jijiaceness/custom-keyboard/photos/info.json_in_progress.png

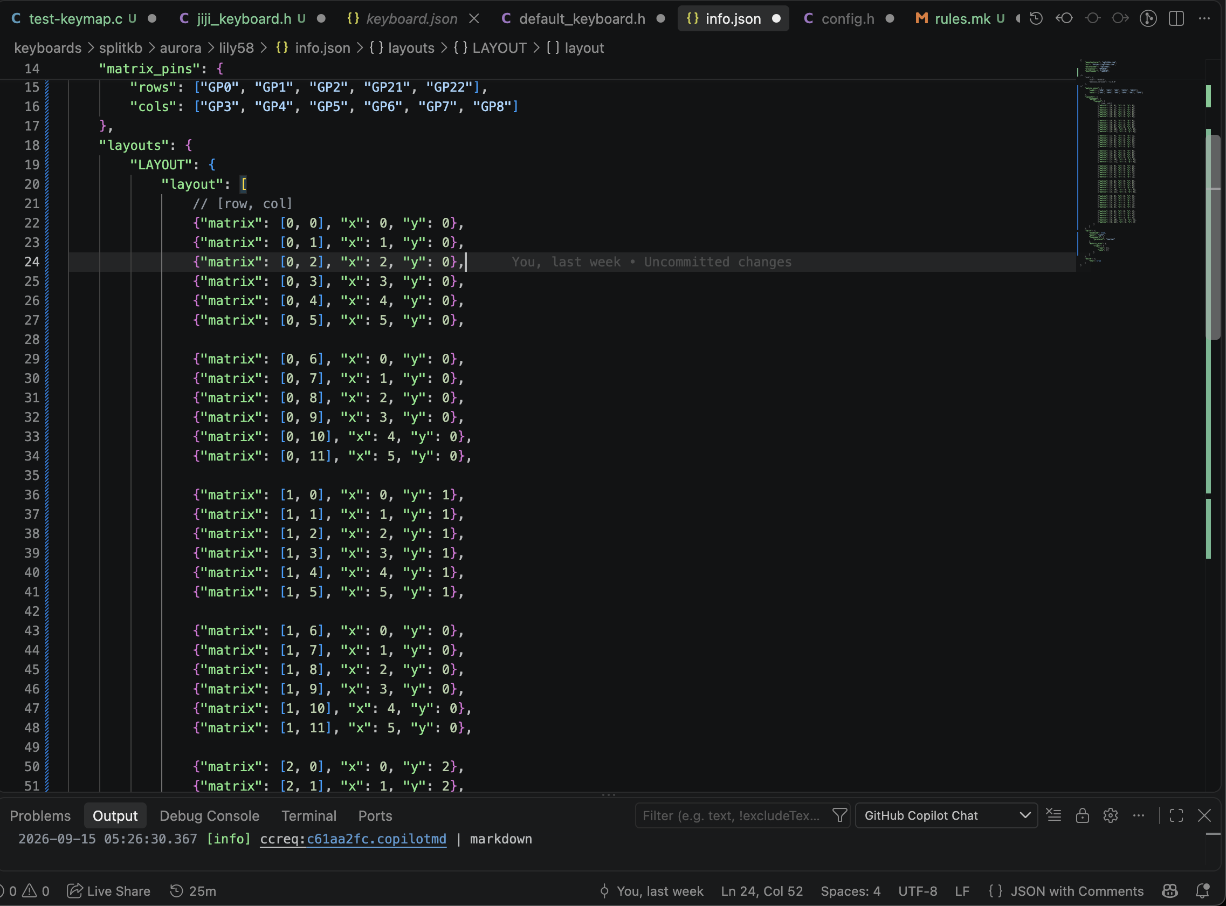
photos/info.json_in_progress.png
