jijiaceness/custom-keyboard/photos/JLCPCB left keeb quote.png

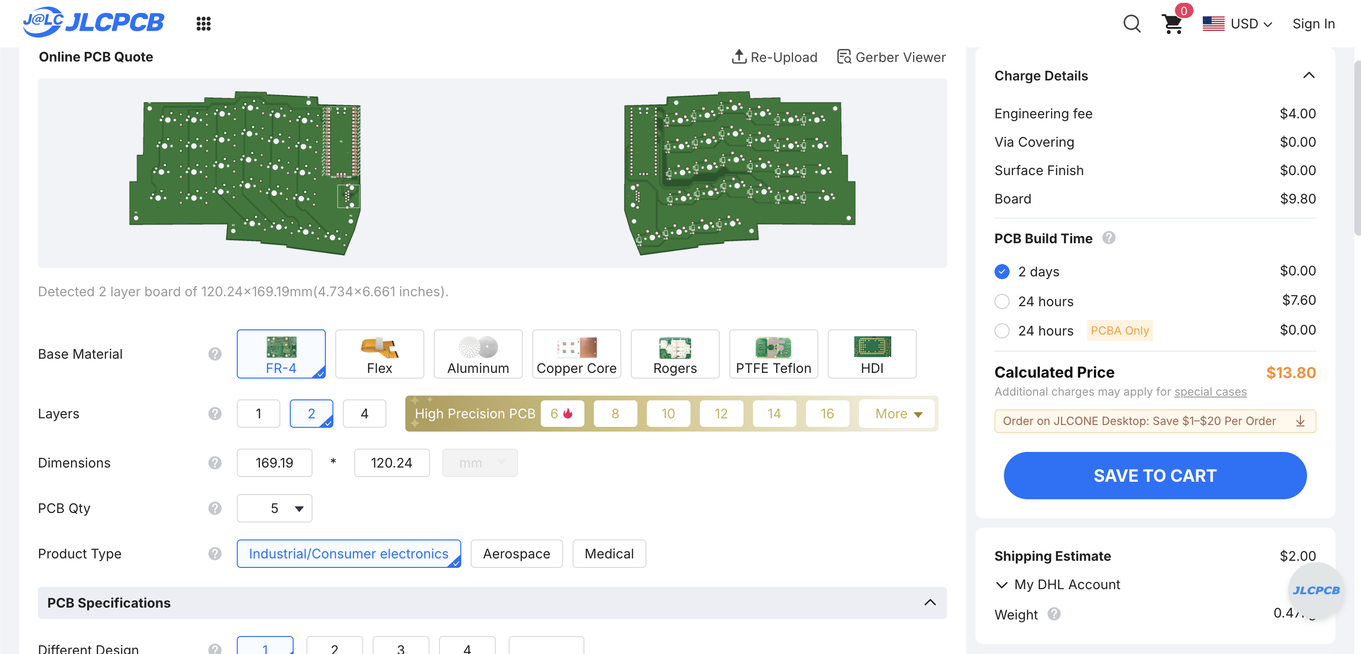
photos/JLCPCB left keeb quote.png
