jijiaceness/custom-keyboard/photos/keeb - model of pcb back.png

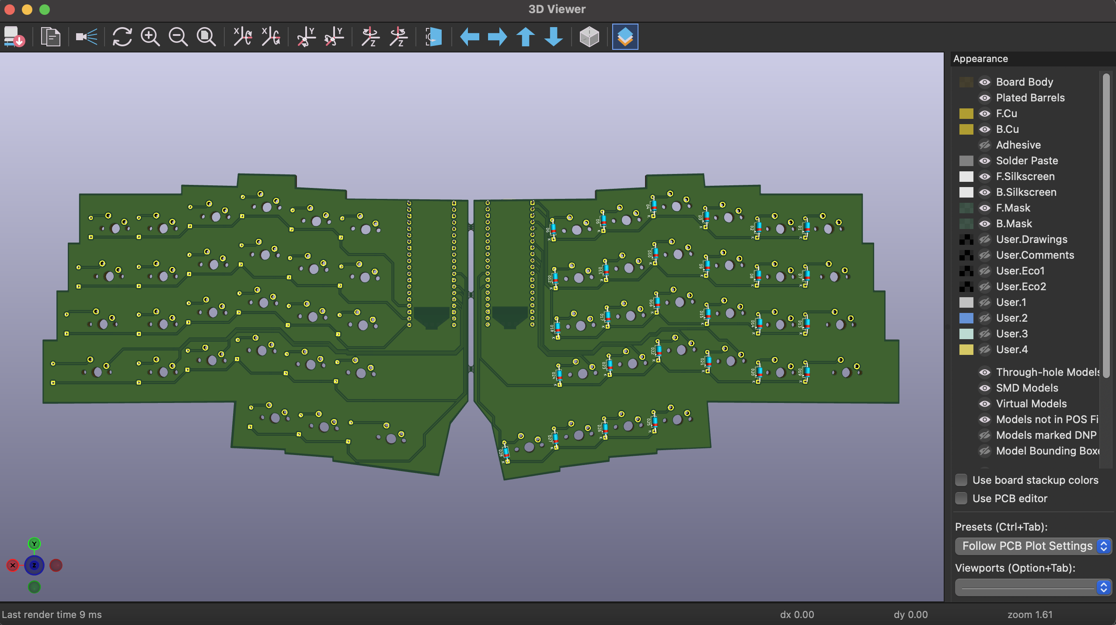
photos/keeb - model of pcb back.png
