jijiaceness/custom-keyboard/photos/keeb - model of pcb front.png

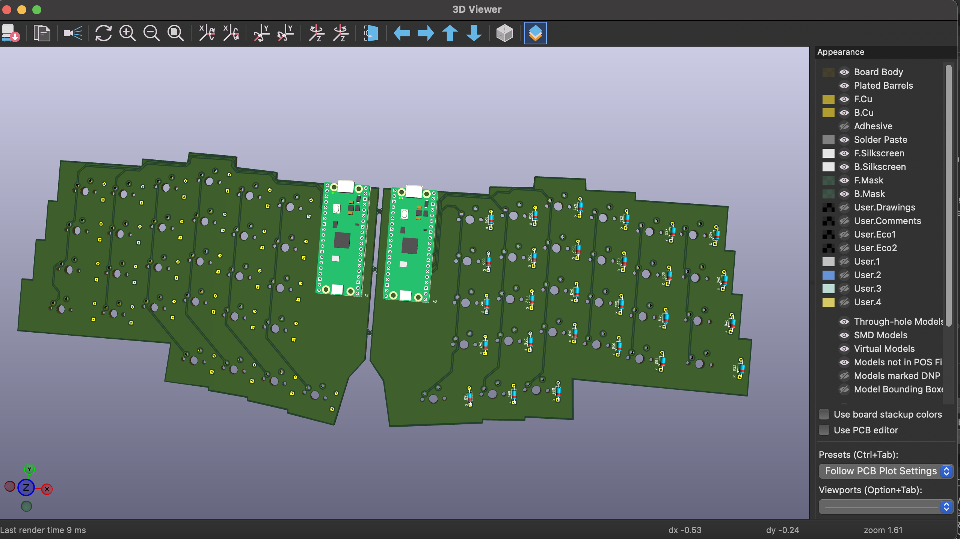
photos/keeb - model of pcb front.png
