jijiaceness/custom-keyboard/photos/kicad_edge_cut.png

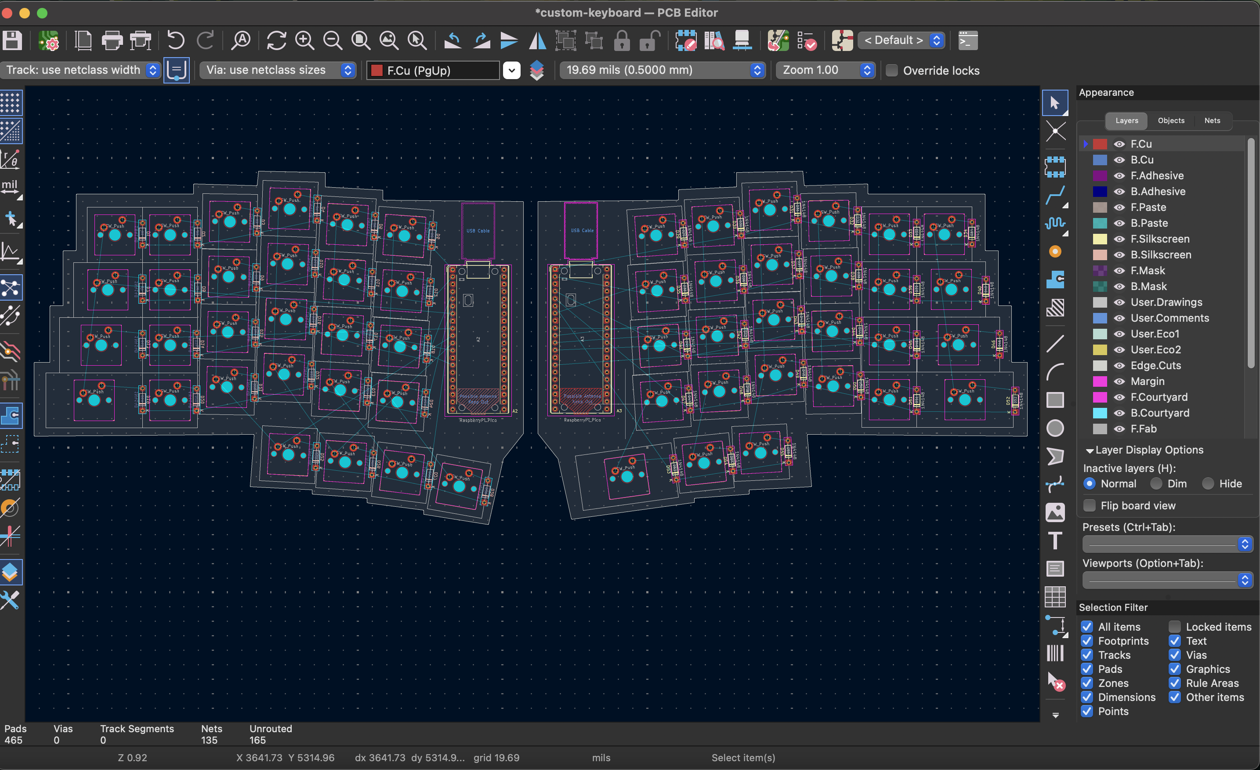
photos/kicad_edge_cut.png
