jijiaceness/custom-keyboard/photos/left PCB model onshape.png

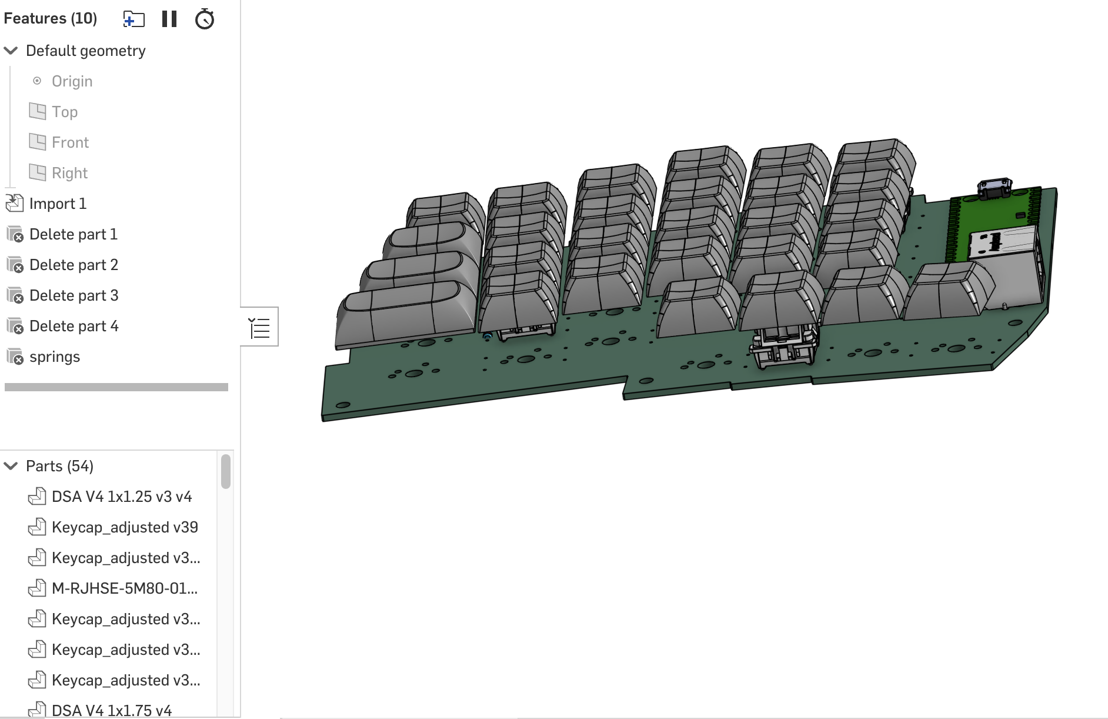
photos/left PCB model onshape.png
