jijiaceness/custom-keyboard/photos/left RJ45 socket layout.png

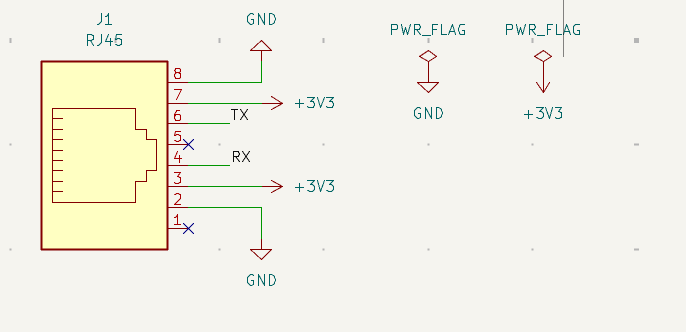
photos/left RJ45 socket layout.png
