jijiaceness/custom-keyboard/photos/left_model_in_progress.png

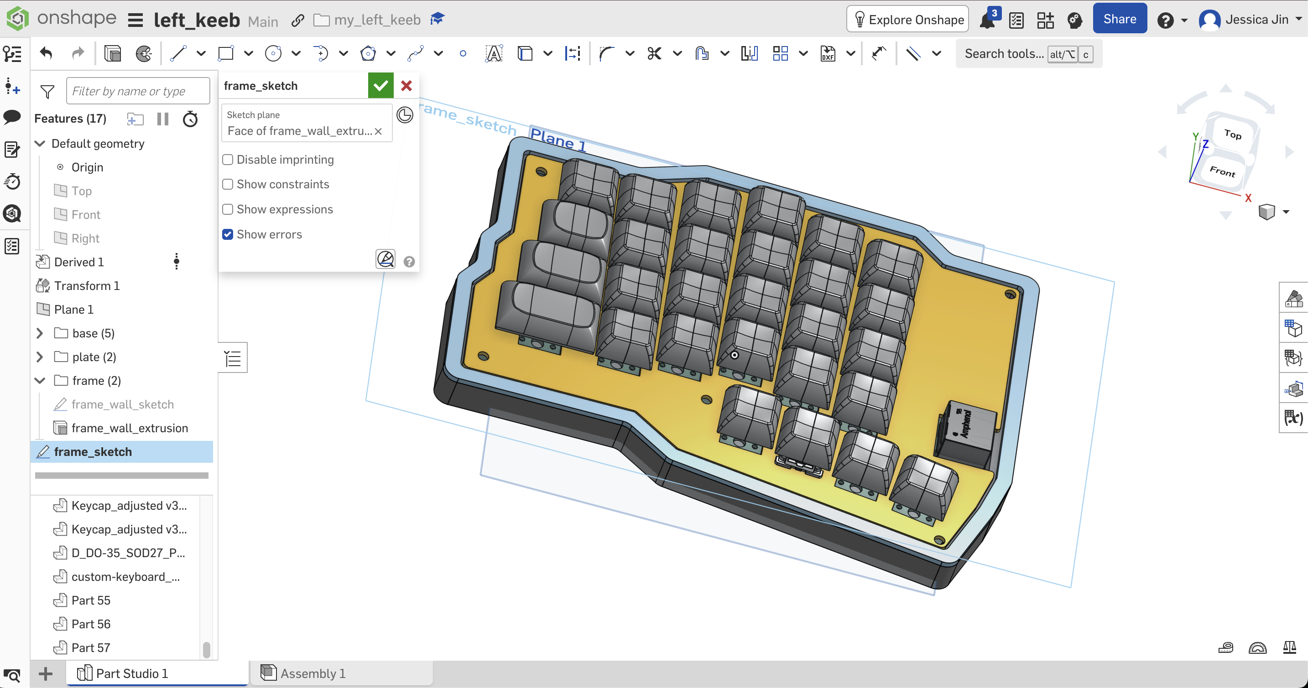
photos/left_model_in_progress.png
