jijiaceness/custom-keyboard/photos/QMK working files.png

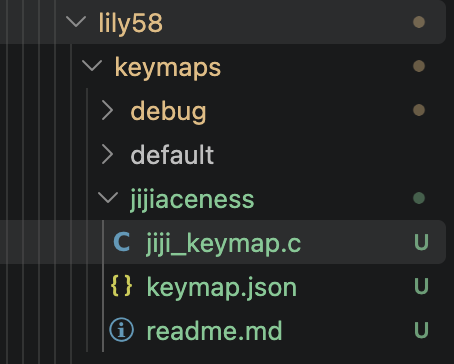
photos/QMK working files.png
