jijiaceness/custom-keyboard/photos/right base sketch.png

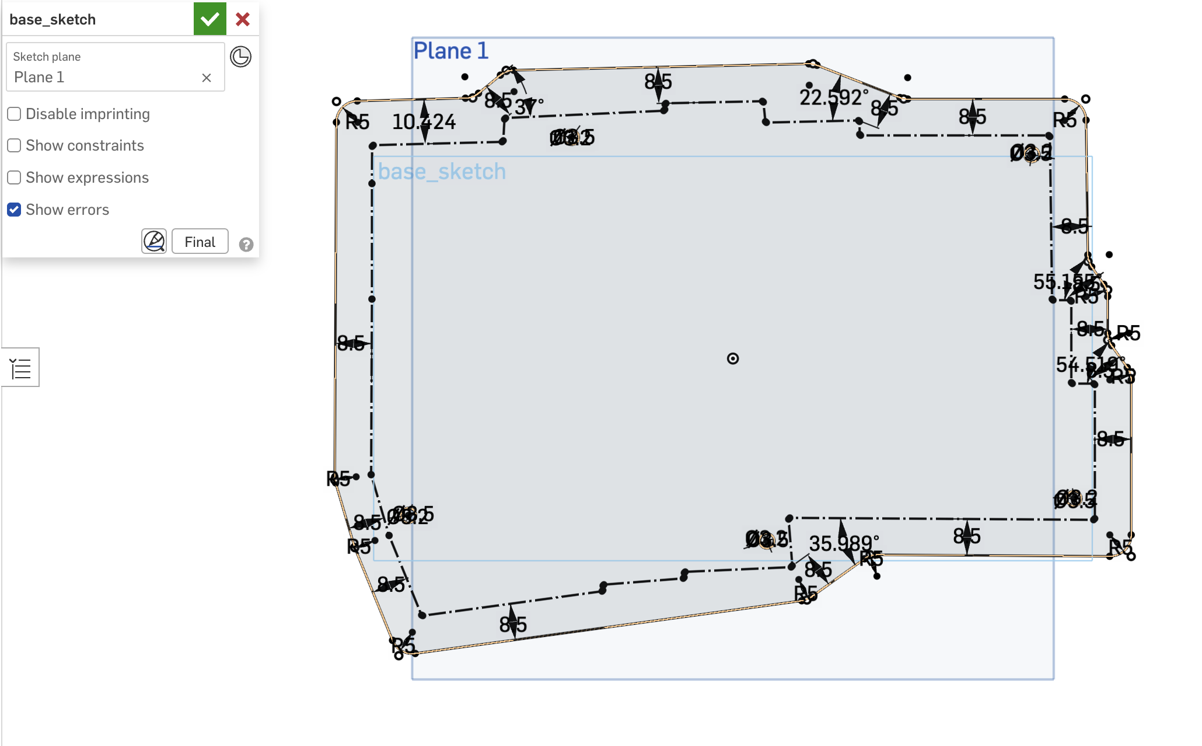
photos/right base sketch.png
