jijiaceness/custom-keyboard/photos/screenshot for keeb -- kicad keyboard layout.png

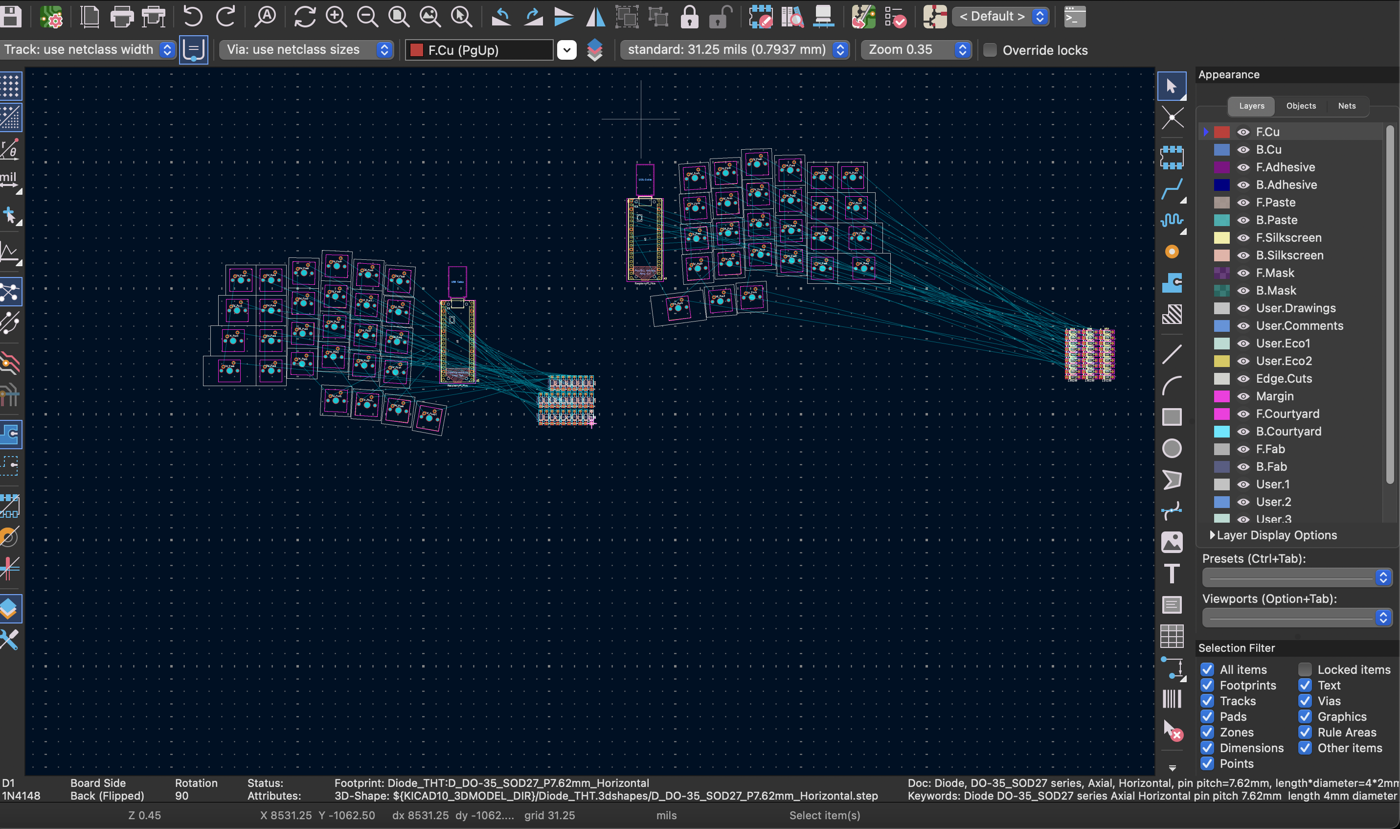
photos/screenshot for keeb -- kicad keyboard layout.png
