jijiaceness/custom-keyboard/3D Case Files/right_keeb.step

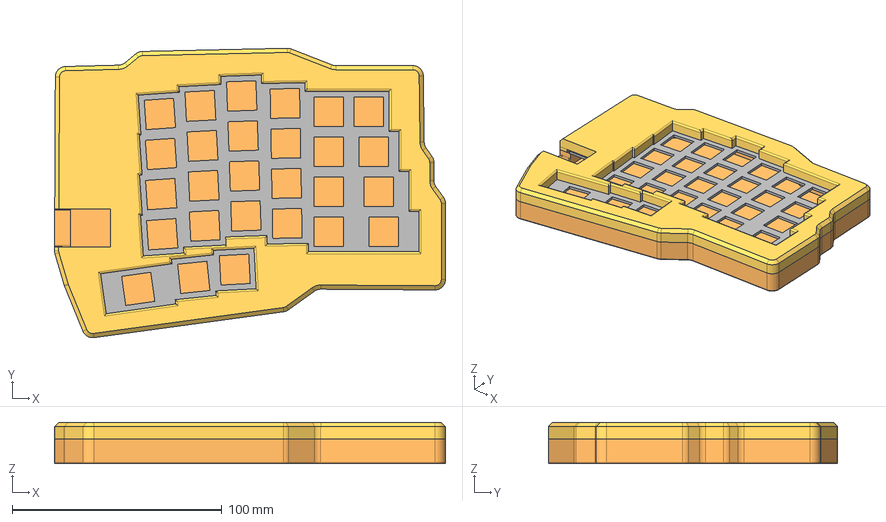
[picture p21: CAD file, 2026-10-26]
3D Case Files/right_keeb.step
186.2 x 137.8 x 19.7 mm
