jijiaceness/custom-keyboard/pcb/right_keyboard.kicad_pcb

## KiCad design pcb/right_keyboard.kicad_pcb (2026-10-26)

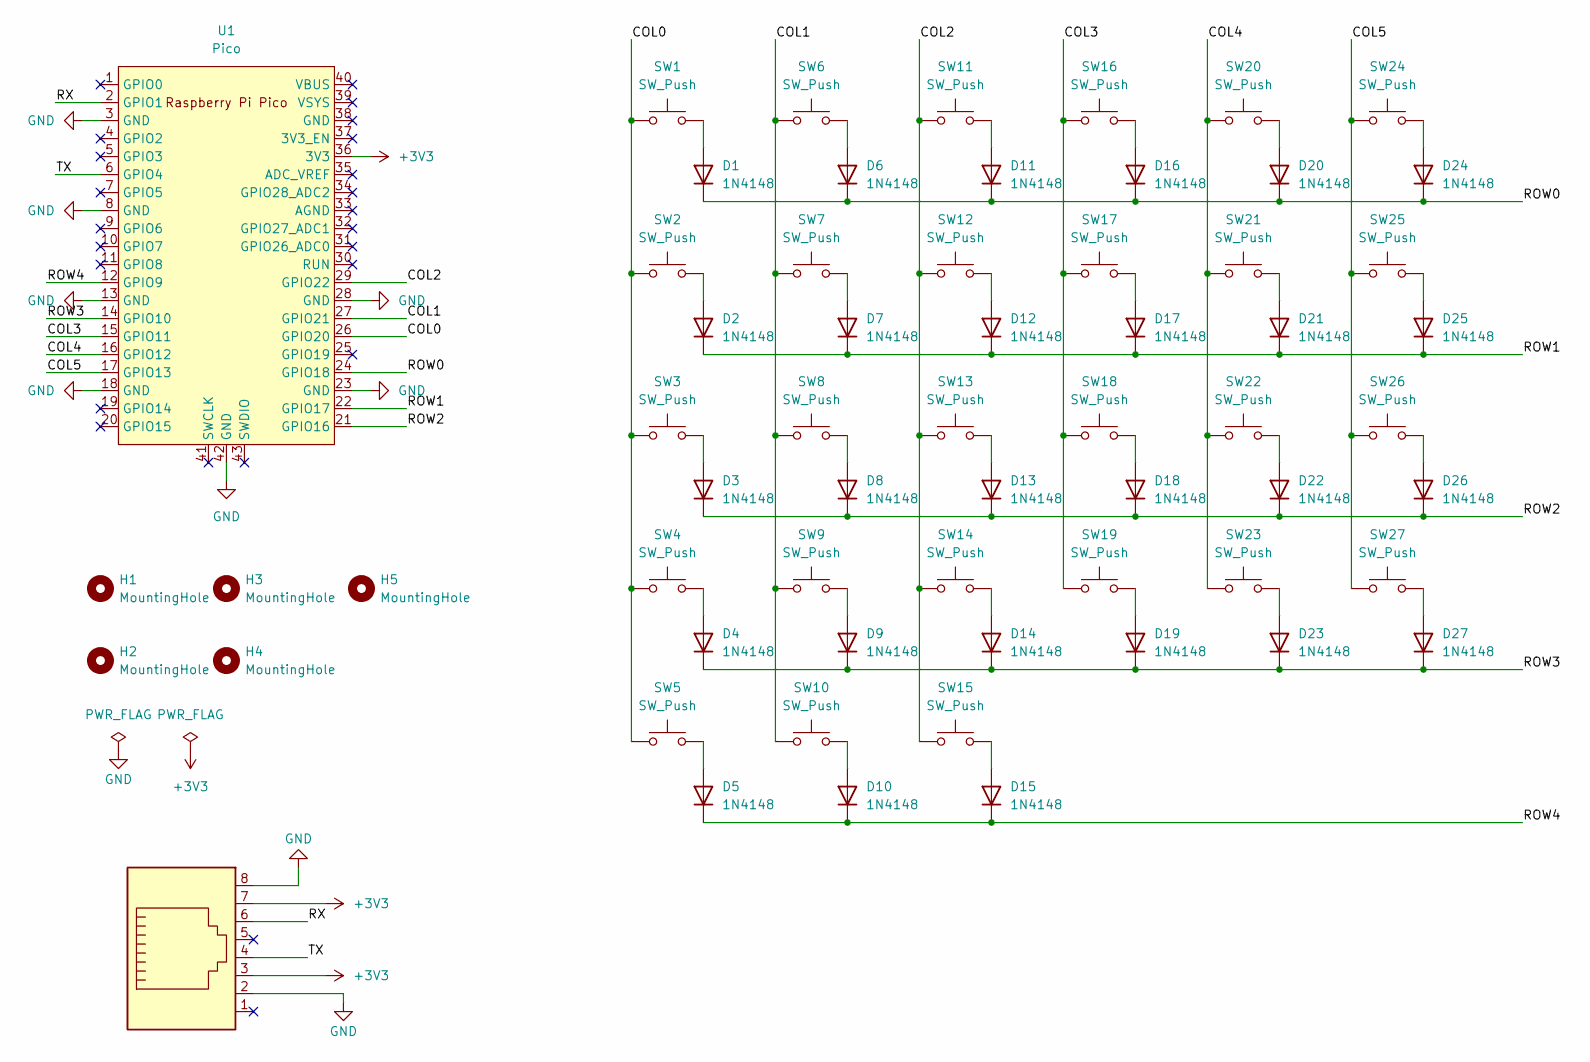
[picture p22: schematic right_keyboard.kicad_sch]

Parts:
D1, D2, D3, D4, D5, D6, D7, D8, D9, D10, D11, D12, D13, D14, D15, D16, D17, D18, D19, D20, D21, D22, D23, D24, D25, D26, D27: 1N4148; D_DO-35_SOD27_P7.62mm_Horizontal
H1, H2, H3, H4, H5: MountingHole; MountingHole_3.2mm_M3
J1: RJ45; RJ45_Amphenol_RJHSE5380
SW1, SW2, SW3, SW4, SW6, SW7, SW8, SW9, SW10, SW11, SW12, SW13, SW14, SW15, SW16, SW17, SW18, SW19, SW20, SW21, SW22, SW23, SW24: SW_Push; SW_MX_1u
SW5, SW27: SW_Push; SW_MX_1.75u
SW25: SW_Push; SW_MX_1.25u
SW26: SW_Push; SW_MX_1.5u
U1: Pico; RPi_Pico_SMD_TH

Connections:
+3V3: J1.3, J1.7, U1.36 (3V3)
/COL0: SW1.1, SW2.1, SW3.1, SW4.1, SW5.1, U1.26 (GPIO20)
/COL1: SW6.1, SW7.1, SW8.1, SW9.1, SW10.1, U1.27 (GPIO21)
/COL2: SW11.1, SW12.1, SW13.1, SW14.1, SW15.1, U1.29 (GPIO22)
/COL3: SW16.1, SW17.1, SW18.1, SW19.1, U1.15 (GPIO11)
/COL4: SW20.1, SW21.1, SW22.1, SW23.1, U1.16 (GPIO12)
/COL5: SW24.1, SW25.1, SW26.1, SW27.1, U1.17 (GPIO13)
/ROW0: D1.1 (K), D6.1 (K), D11.1 (K), D16.1 (K), D20.1 (K), D24.1 (K), U1.24 (GPIO18)
/ROW1: D2.1 (K), D7.1 (K), D12.1 (K), D17.1 (K), D21.1 (K), D25.1 (K), U1.22 (GPIO17)
/ROW2: D3.1 (K), D8.1 (K), D13.1 (K), D18.1 (K), D22.1 (K), D26.1 (K), U1.21 (GPIO16)
/ROW3: D4.1 (K), D9.1 (K), D14.1 (K), D19.1 (K), D23.1 (K), D27.1 (K), U1.14 (GPIO10)
/ROW4: D5.1 (K), D10.1 (K), D15.1 (K), U1.12 (GPIO9)
/RX: J1.6, U1.2 (GPIO1)
/TX: J1.4, U1.6 (GPIO4)
GND: J1.2, J1.8, U1.3 (GND), U1.8 (GND), U1.13 (GND), U1.18 (GND), U1.23 (GND), U1.28 (GND), U1.42 (GND)
unnamed: D1.2 (A), SW1.2
unnamed: D2.2 (A), SW2.2
unnamed: D3.2 (A), SW3.2
unnamed: D4.2 (A), SW4.2
unnamed: D5.2 (A), SW5.2
unnamed: D6.2 (A), SW6.2
unnamed: D7.2 (A), SW7.2
unnamed: D8.2 (A), SW8.2
unnamed: D9.2 (A), SW9.2
unnamed: D10.2 (A), SW10.2
unnamed: D11.2 (A), SW11.2
unnamed: D12.2 (A), SW12.2
unnamed: D13.2 (A), SW13.2
unnamed: D14.2 (A), SW14.2
unnamed: D15.2 (A), SW15.2
unnamed: D16.2 (A), SW16.2
unnamed: D17.2 (A), SW17.2
unnamed: D18.2 (A), SW18.2
unnamed: D19.2 (A), SW19.2
unnamed: D20.2 (A), SW20.2
unnamed: D21.2 (A), SW21.2
unnamed: D22.2 (A), SW22.2
unnamed: D23.2 (A), SW23.2
unnamed: D24.2 (A), SW24.2
unnamed: D25.2 (A), SW25.2
unnamed: D26.2 (A), SW26.2
unnamed: D27.2 (A), SW27.2

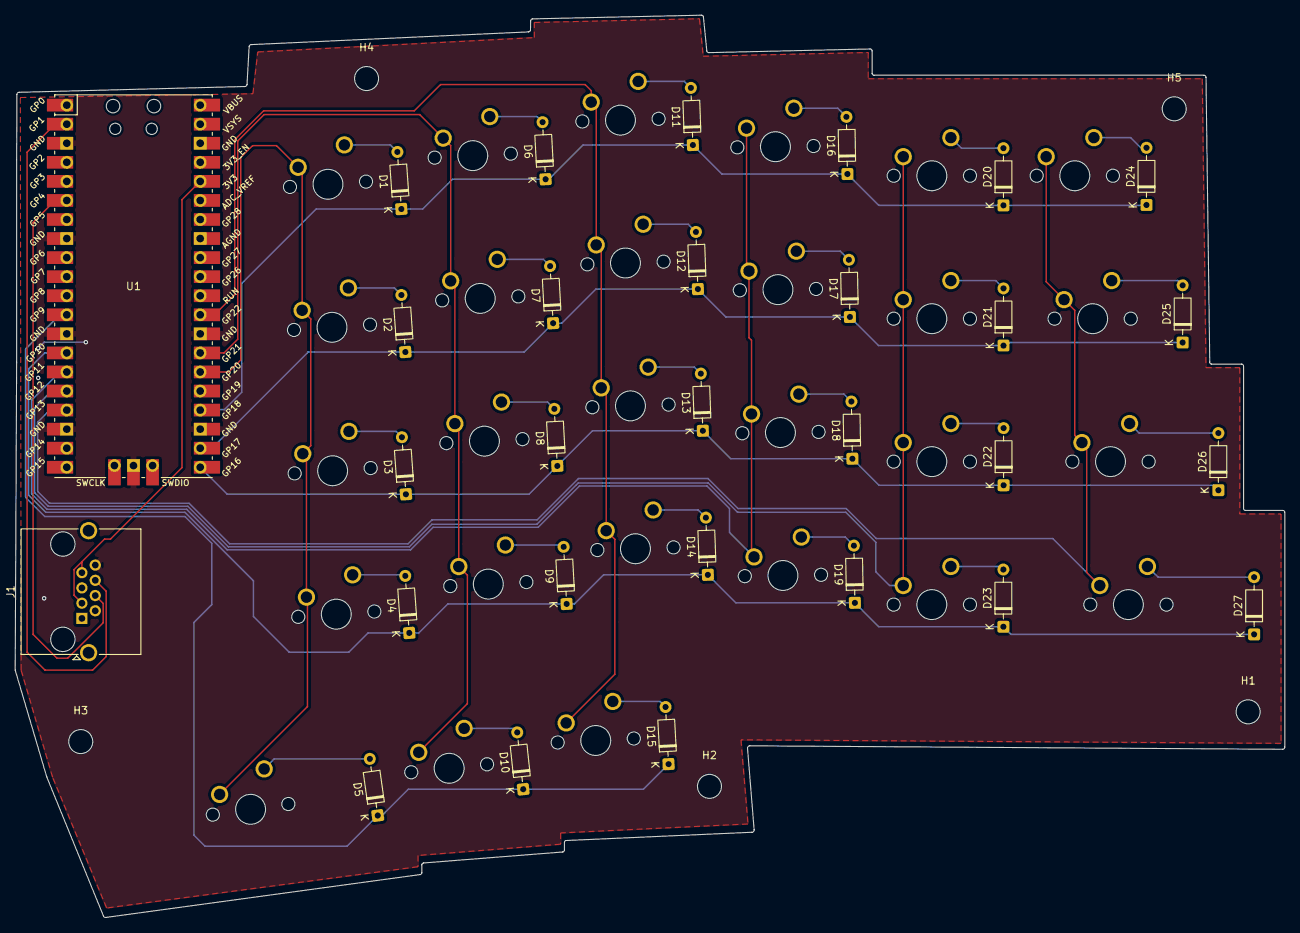
[picture p23: board right_keyboard.kicad_pcb from above]

Board: 2 copper layers, 169.2 x 120.2 mm, 61 parts (0 on the bottom side), 42 nets.
