jijiaceness/custom-keyboard/(commit log)

2026-07-21 Add files via upload
    Gerber files for the left split keyboard
    [custom-keyboard-B_Cu.gbr, custom-keyboard-B_Mask.gbr, custom-keyboard-B_Paste.gbr, custom-keyboard-B_Silkscreen.gbr, custom-keyboard-Edge_Cuts.gbr, custom-keyboard-F_Cu.gbr, custom-keyboard-F_Mask.gbr, custom-keyboard-F_Paste.gbr]
2026-07-21 Add files via upload
    Gerber files for the right split keyboard
    [right_keyboard-B_Cu.gbr, right_keyboard-B_Mask.gbr, right_keyboard-B_Paste.gbr, right_keyboard-B_Silkscreen.gbr, right_keyboard-Edge_Cuts.gbr, right_keyboard-F_Cu.gbr, right_keyboard-F_Mask.gbr, right_keyboard-F_Paste.gbr]
2026-08-04 Hour 3: Made Schematic and Assigned Footprints in KiCad
    I finished the schematic and assigned the switches, diodes, and Raspberry Pi Picos’ footprints. I had to make two sheets on the schematic since I was doing a split keyboard, and learning all of KiCAD’s features took a while to get used to as a complete beginner, which was why this process took me 3 hours.
2026-08-04 Hour 5: Made keyboard arrangement and edge cuts in PCB Editor
    I arranged the switches, diodes, and Raspberry Pi Picos in to the shape I wanted in the PCB Editor. It was more difficult than i had imagined because the switches often weren't snapping into place and I had to rotate keys to achieve the layout I wanted.
    I also had to play around with the corner radius on the edge cut since the lines were much shorter than typical keyboard edge cuts.
2026-08-10 Hour 7: Routing and filling the PCB
    I routed all of the switches and diodes to the Raspberry Pi Pico with the corresponding ratsnets, adding a ground fill after. I did have to go back and modify the
    schematic so I could route all the traces without them intersecting.
2026-08-14 Hour 11: Fix and Revise PCB
    I realized I needed a socket on both PCBs so I could use a cable to connect the two parts, so I used the RJ45 socket for an Ethernet cable.
    I also fixed the numerous errors I had with my PCB (It was my first time designing a PCB so I had over 100 warnings and 20 errors) until I had none
    except for a minor warning about the silkscreen being clipped by the board edge.
2026-09-02 Hour 14: Prototype of Right Keeb Case with Bottom and Top Plate
2026-09-06 Hour 17: Left Keeb Case with Base and Top Plate
2026-09-21 Moved all pcb files under 1 folder
    [custom-keyboard-B_Cu.gbr, custom-keyboard-B_Mask.gbr, custom-keyboard-B_Paste.gbr, custom-keyboard-B_Silkscreen.gbr, custom-keyboard-Edge_Cuts.gbr, custom-keyboard-F_Cu.gbr, custom-keyboard-F_Mask.gbr, custom-keyboard-F_Paste.gbr]
2026-09-21 Deleted left keeb and right keeb files outside since they were in pcb folder
    [custom-keyboard-B_Cu.gbr, custom-keyboard-B_Mask.gbr, custom-keyboard-B_Paste.gbr, custom-keyboard-B_Silkscreen.gbr, custom-keyboard-Edge_Cuts.gbr, custom-keyboard-F_Cu.gbr, custom-keyboard-F_Mask.gbr, custom-keyboard-F_Paste.gbr]
2026-09-21 Added case files from Onshape
    [left_keeb.step, right_keeb.step]
2026-09-27 Draft of development journal: designing the PCB
    Draft of first part of Journal.md documenting the process of brainstorming and designing the PCB (some photos haven't been put in yet).
2026-09-27 Revised PCB section and added necessary photos
    Updated the journal with final versions of schematics and PCBs as well as RJ45 screenshots.
2026-09-29 Added BOM.csv
    [BOM.csv]
2026-09-29 Draft of README
    Added overview of project including features, what I learned, challenges, and a bill of materials.
2026-09-29 Added firmware files and final case photos
2026-09-29 Finalized README
    I added case photos and made some small edits to the README.
2026-09-29 Added BOM draft
2026-09-29 Moved BOM sheet screenshot to photos folder
2026-09-29 Added kicad pcb and sch files
    [left-keyboard.kicad_pcb, left-keyboard.kicad_sch, right_keyboard.kicad_pcb, right_keyboard.kicad_sch]
2026-09-29 Updated quantities of switches and diodes
    [BOM.csv]
2026-09-29 Re-updated quantities
    The original quantities were correct
    [BOM.csv]
