jijiaceness/custom-keyboard/photos/second_keeb_sketch.jpeg

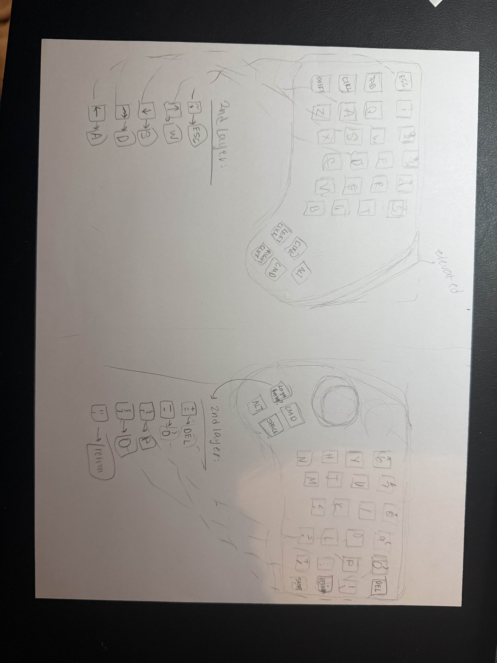
photos/second_keeb_sketch.jpeg
